moraszk/space-noise-o-meter/README.md

Móra Space module
=================

Students from Ferenc Mora College for Advanced Studies developed a payload for the MRC-100 satellite. These are the sources of it.
