moraszk/space-noise-o-meter/doc/report.tex

\subsection{Mass}
\vspace{15mm}
\begin{tabular}{@{}C{1.5in}@}
	\hrulefill & \hfill \\
	Identifier & \hfill \\
\end{tabular}
\vspace{25mm}

\begin{tabular}{@{}C{1.5in}p{1in}C{1.5in}p{1in}C{1.5in}@{}}
	\hrulefill & \hfill & \hrulefill & \hfill & \hrulefill\\
	Instrument & \hfill & Mass & \hfill & Signature \\
\end{tabular}

\subsection{Current at $V_{in}=3.3V$}
\vspace{25mm}
\begin{tabular}{@{}C{1.5in}p{1in}C{1.5in}p{1in}C{1.5in}@{}}
	\hrulefill & \hfill & \hrulefill & \hfill & \hrulefill\\
	Instrument & \hfill & Current & \hfill & Signature \\
\end{tabular}

\subsection{Thermal-chamber}
\vspace{25mm}
\begin{tabular}{@{}C{1.5in}p{1in}C{1.5in}p{1in}C{1.5in}@{}}
	\hrulefill & \hfill & \hrulefill & \hfill & \hrulefill\\
	Instrument & \hfill & Pass & \hfill & Signature \\
\end{tabular}
