moraszk/space-noise-o-meter/presentation/mrc_napok.tex

\begin{frame}{SZTE Akadémiai modul}
\begin{columns}[c]
\column{.5\textwidth}
\begin{block}{Megvalósulás}
2022Q1-Q2, két kar, kari és intézeti költségvetésekből, a lehetőséget a BME biztosította
\end{block}
\begin{block}{Kísérletek}
	\begin{itemize}
		\item Különböző elvű hőmérséklet mérések
		\item A belső oszcillátor kalibrációs adatainak mérése
	\end{itemize}
\end{block}

\column{.45\textwidth}
	\begin{center}
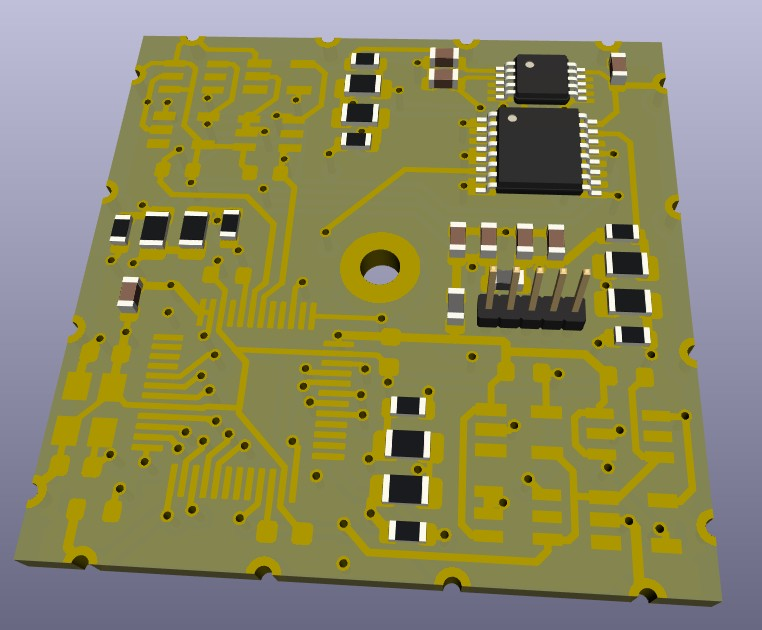
[picture p1: presentation/tanszeki3d.jpg]
		
	\end{center}

\end{columns}
\end{frame}

\begin{frame}{SZTE Diák-modul}
\begin{columns}
\column{.45\textwidth}
	\begin{center}
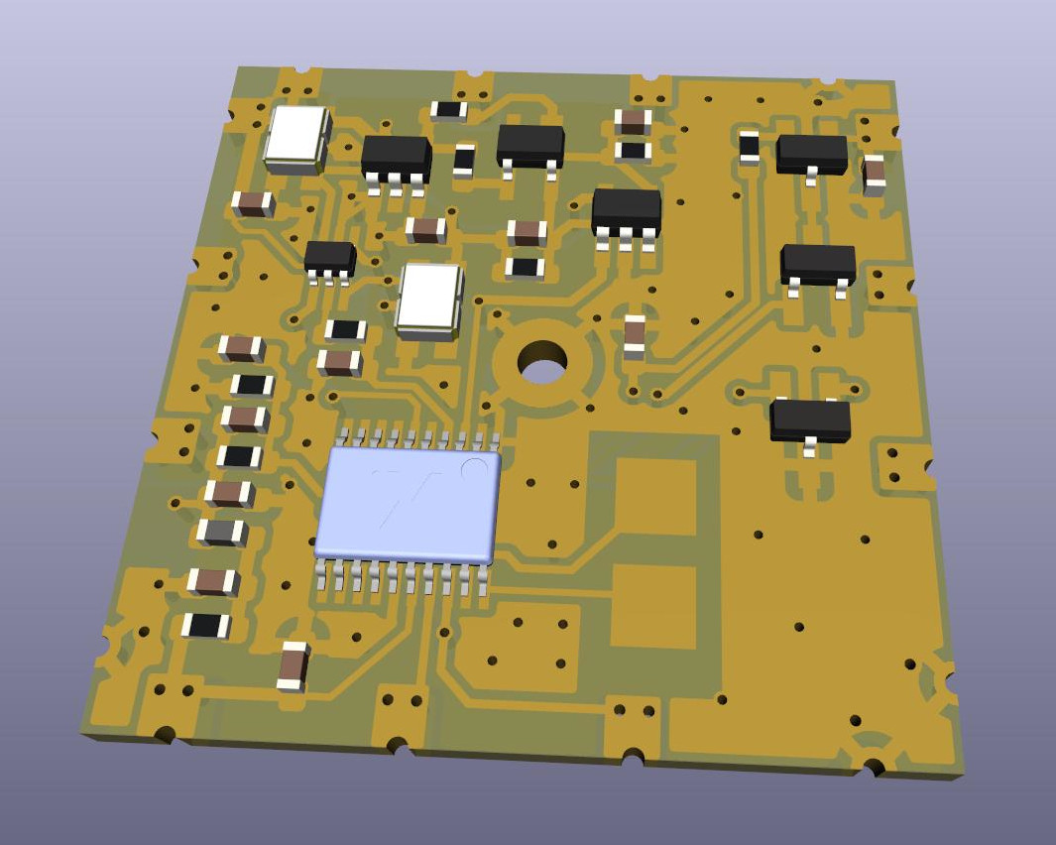
[picture p2: presentation/3d_render.jpg]
		
	\end{center}
	\begin{block}{Szponzoraink}
			
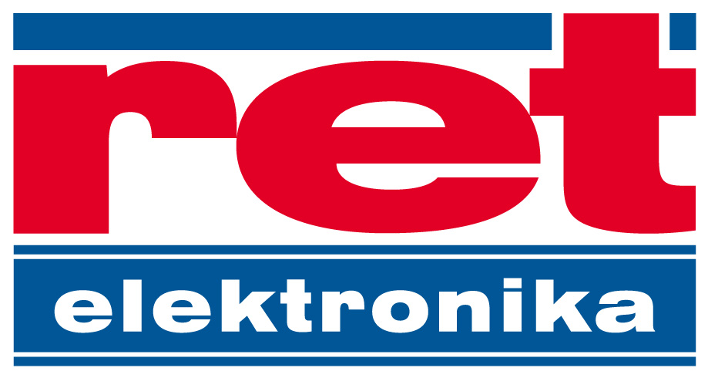
[picture p3: presentation/ret.jpg]
			
			
			
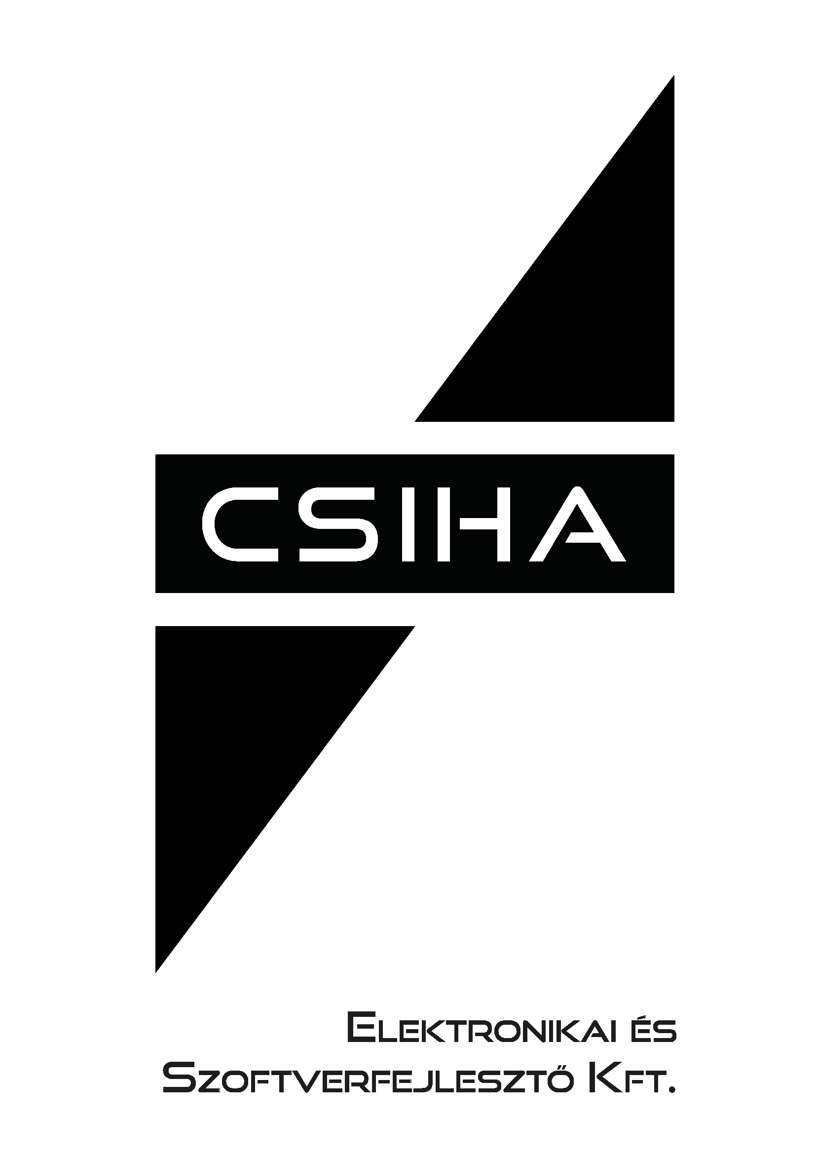
[picture p4: presentation/csiha.png]
			
	\end{block}
\column{.5\textwidth}
	\begin{block}{Megvalósulás}
		\small{2022 szeptember 30--október 24, kizárólag diákok tervezésével és menedzselésével az SZTE Móra Ferenc Szakkollégiumban. A lehetőséget a BME biztosította.}
	\end{block}
	\begin{block}{Kísérletek}
		\begin{itemize}
			\item STM32 beépített ADC viselkedése
			\item A közös busz UART jitterének mérése modulonként
			\item Helyi bölcsész közösség idézetgyűjteménye
			\item Mágneses indukcióerősség mérés
			\item Hőmérséklet mérés
			\item TicTacToe
		\end{itemize}
	\end{block}
\end{columns}
\end{frame}
