moraszk/space-noise-o-meter/presentation/sponsors.tex

\begin{frame}{Szponzoraink}





\end{frame}

\begin{frame}{Felhasznált nyílt kódú szoftverek}
	\LaTeX
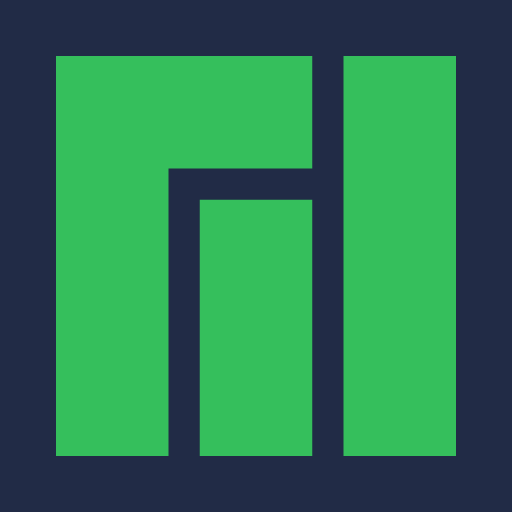
[picture p15: presentation/manjaro.png]
	
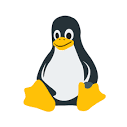
[picture p16: presentation/linux.png]
	
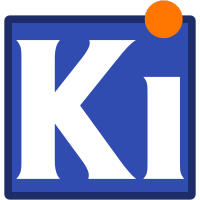
[picture p17: presentation/kicad.png]
	
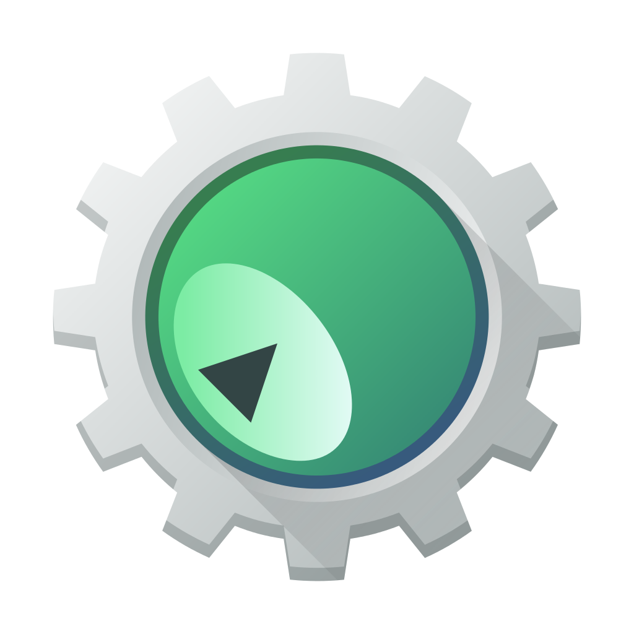
[picture p18: presentation/kdevelop.png]
	
	
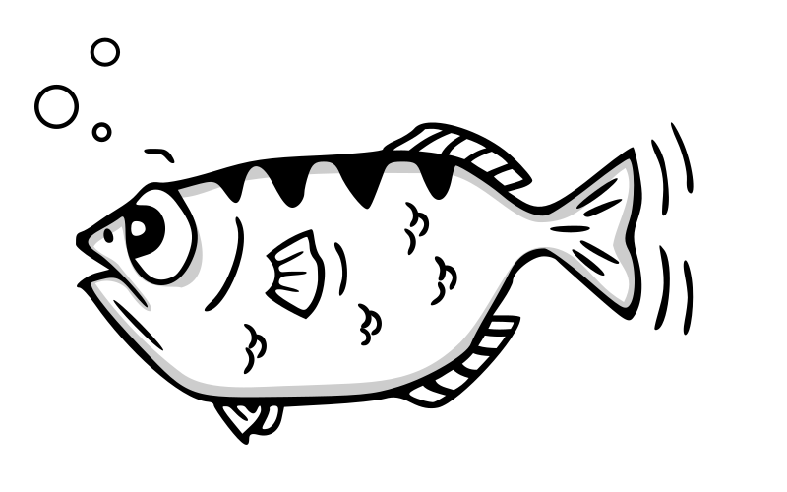
[picture p19: presentation/gdb.png]
	
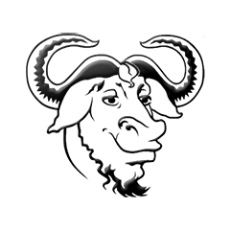
[picture p20: presentation/make.png]
	
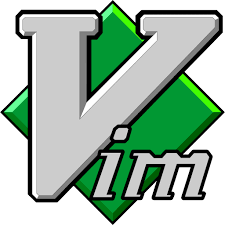
[picture p21: presentation/vim.png]
	
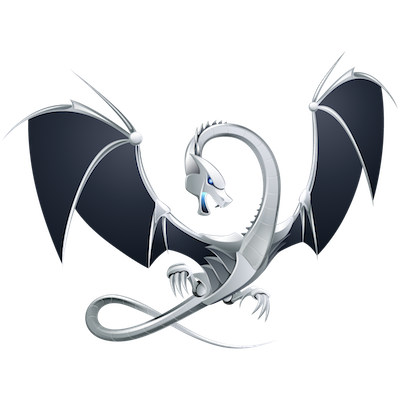
[picture p22: presentation/llvm.png]
	
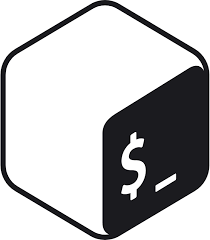
[picture p23: presentation/bash.png]
	
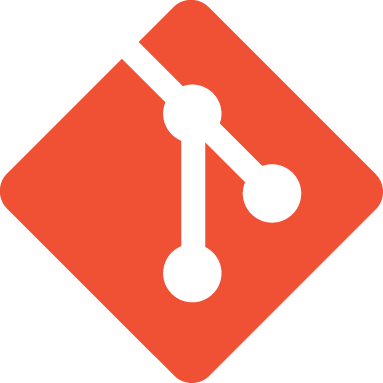
[picture p24: presentation/git.png]
	
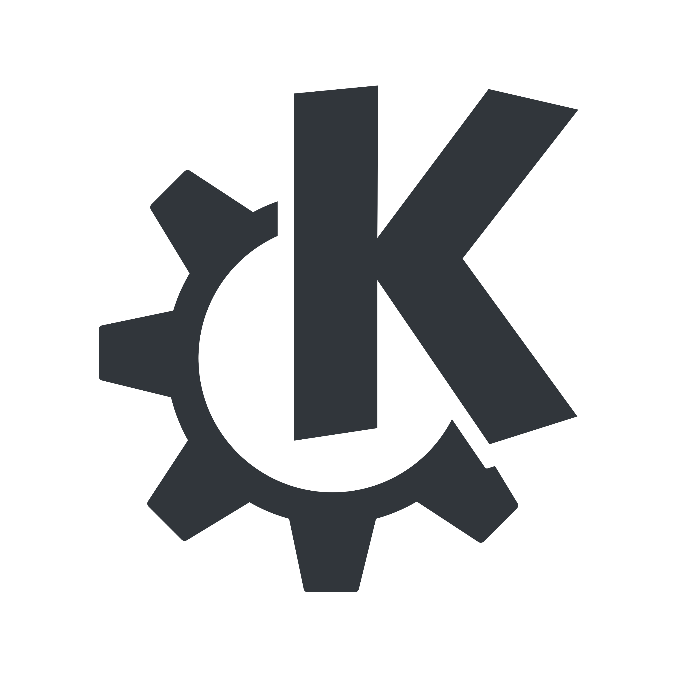
[picture p25: presentation/kde.png]
	
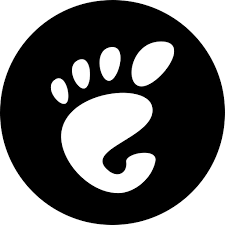
[picture p26: presentation/gnome.png]
	
\end{frame}
