moraszk/space-noise-o-meter/presentation/mfhe.jpeg

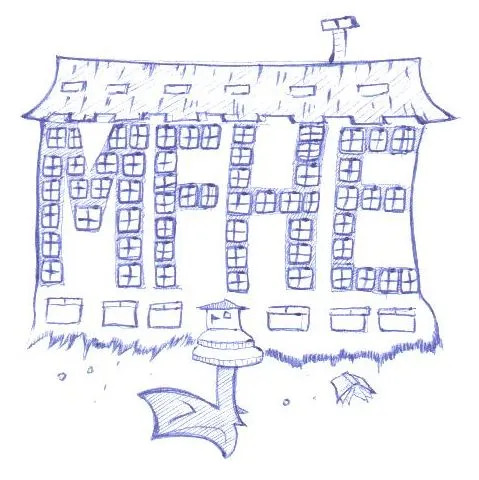
presentation/mfhe.jpeg
