moraszk/space-noise-o-meter/presentation/rocketlab.png

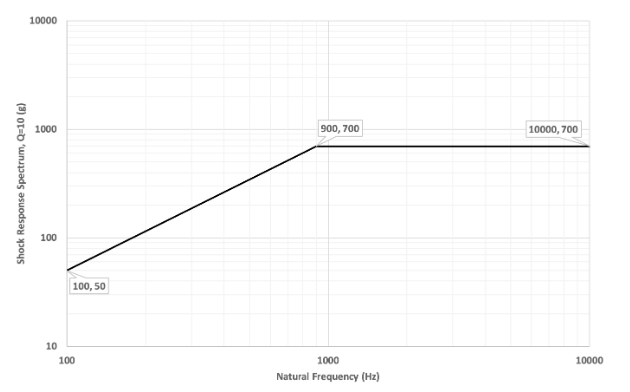
presentation/rocketlab.png
