moraszk/space-noise-o-meter/hw/footprint/farnell/xtal_osc_3.2x2.5.step

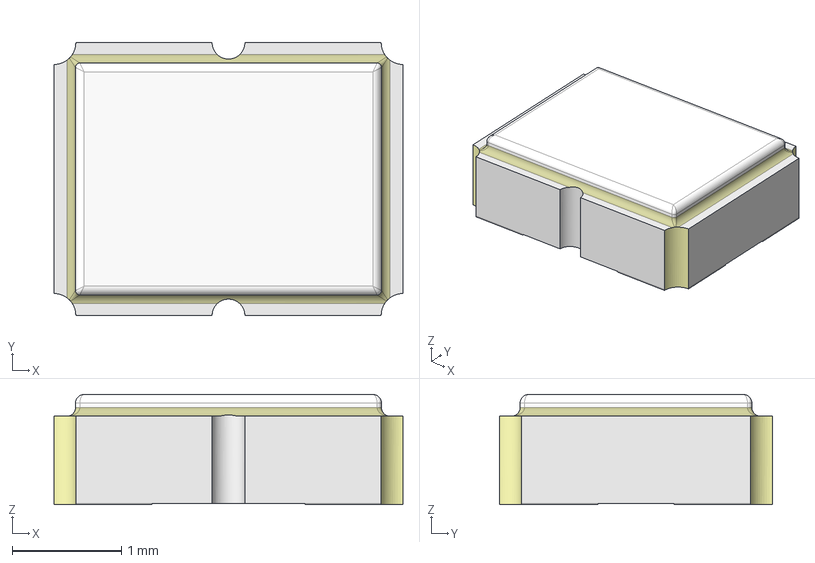
[picture p33: CAD file, 2022-10-05]
hw/footprint/farnell/xtal_osc_3.2x2.5.step
3.20 x 2.50 x 1.01 mm
