moraszk/space-noise-o-meter/hw/module.step

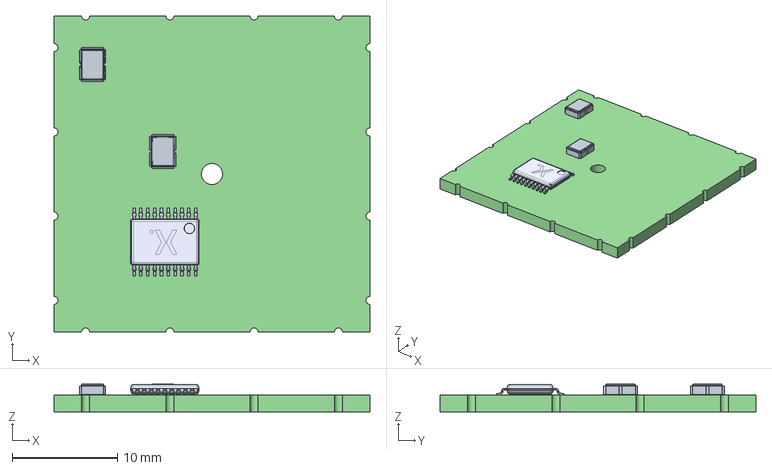
[picture p34: CAD file, 2022-10-10]
hw/module.step
30.0 x 30.0 x 2.65 mm
module PCB
