moraszk/space-noise-o-meter/hw/footprint/farnell/SOT360-1.step

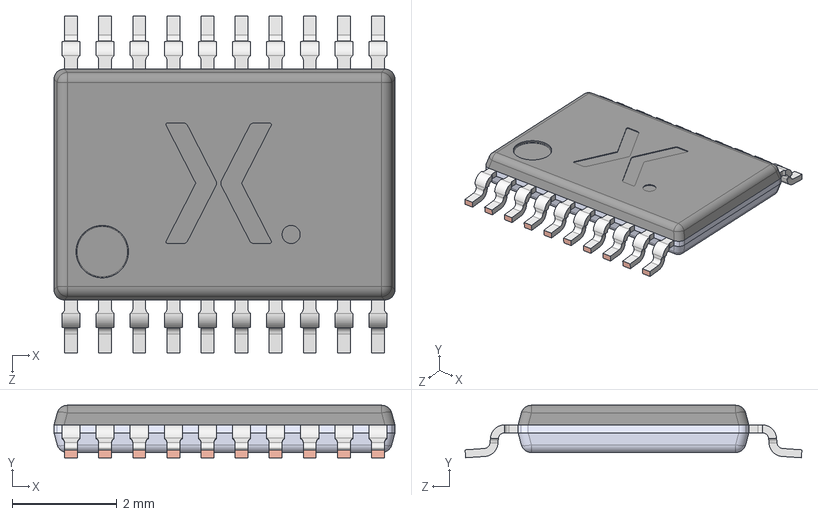
[picture p35: CAD file, 2022-10-04]
hw/footprint/farnell/SOT360-1.step
6.50 x 1.00 x 6.42 mm
SOT360-1 Lower Mold body
SOT360-1 Lead
SOT360-1 Upper Mold body
