moraszk/space-noise-o-meter/doc/sch.pdf

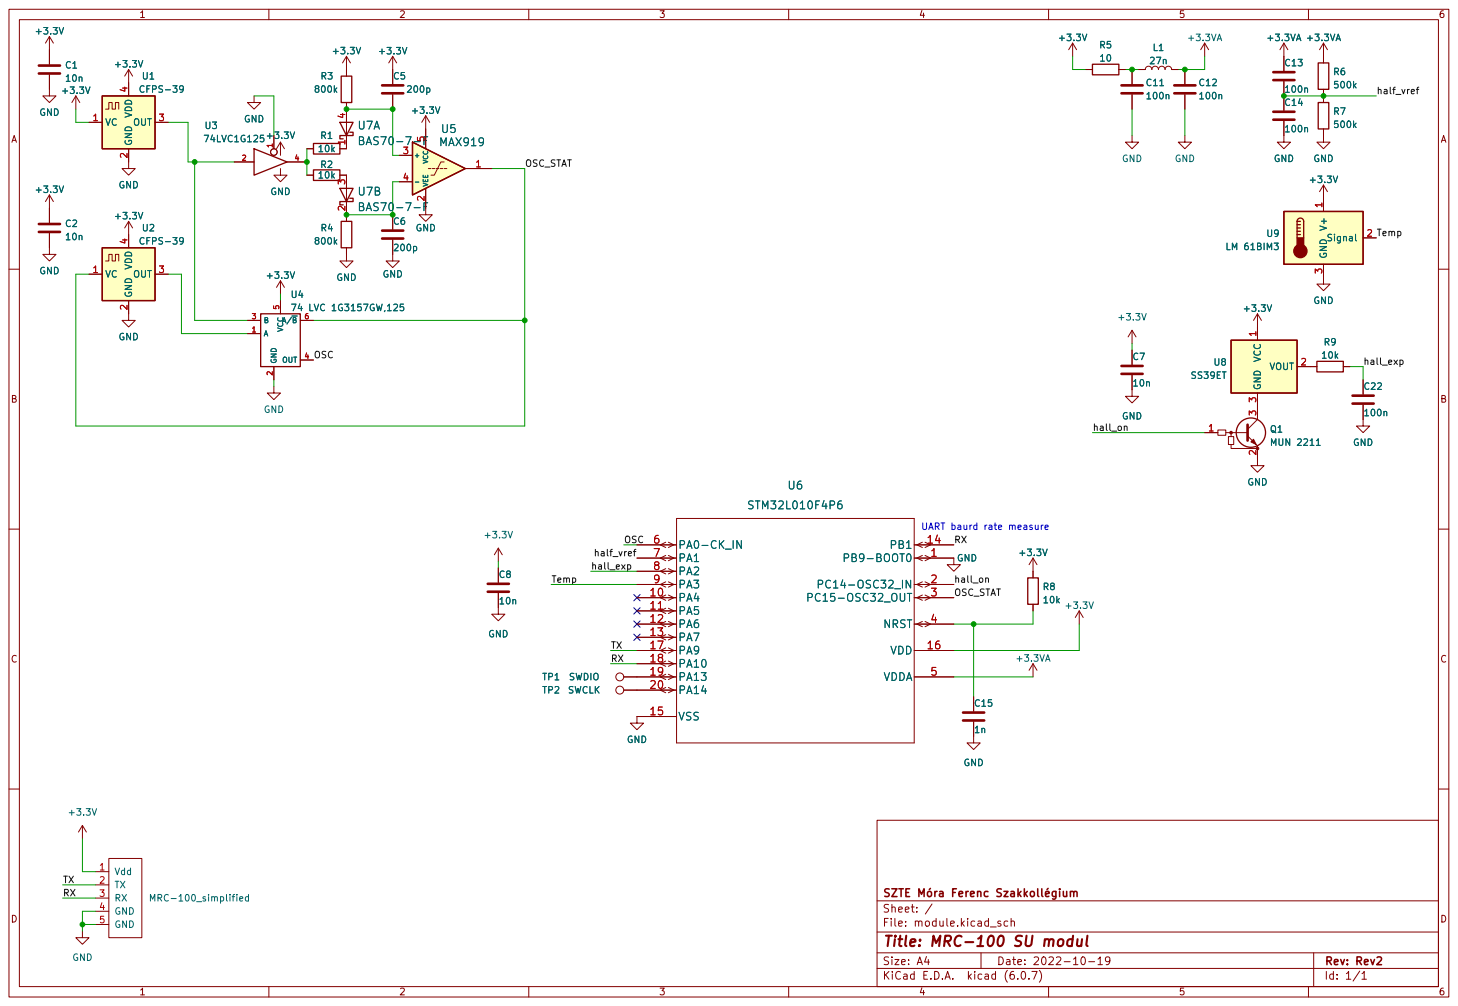
[picture p36: page 1]

File: module.kicad_sch Sheet: / þÿSZTE Móra Ferenc Szakkollégium

Id: 1/1 Title: MRC-100 SU modul
