moraszk/space-noise-o-meter/hw/osc_detect.asc

A1: inv; Vhigh=3.3
C1: cap; 200p
C2: cap; 200p
D1: diode; BAS21HY
D2: diode; BAS21HY
R1: res; 10k
R2: res; 800k
R3: res; 800k
R4: res; 1
R5: res; 100k
R6: res; 10k
V1: voltage; SINE(1.65 1.65 10000000)
V2: voltage; 3.3
Named nets: 0, low, high
.tran 100u uic
