moraszk/space-noise-o-meter/hw/module.kicad_pcb

## KiCad design hw/module.kicad_pcb (2022-10-22)

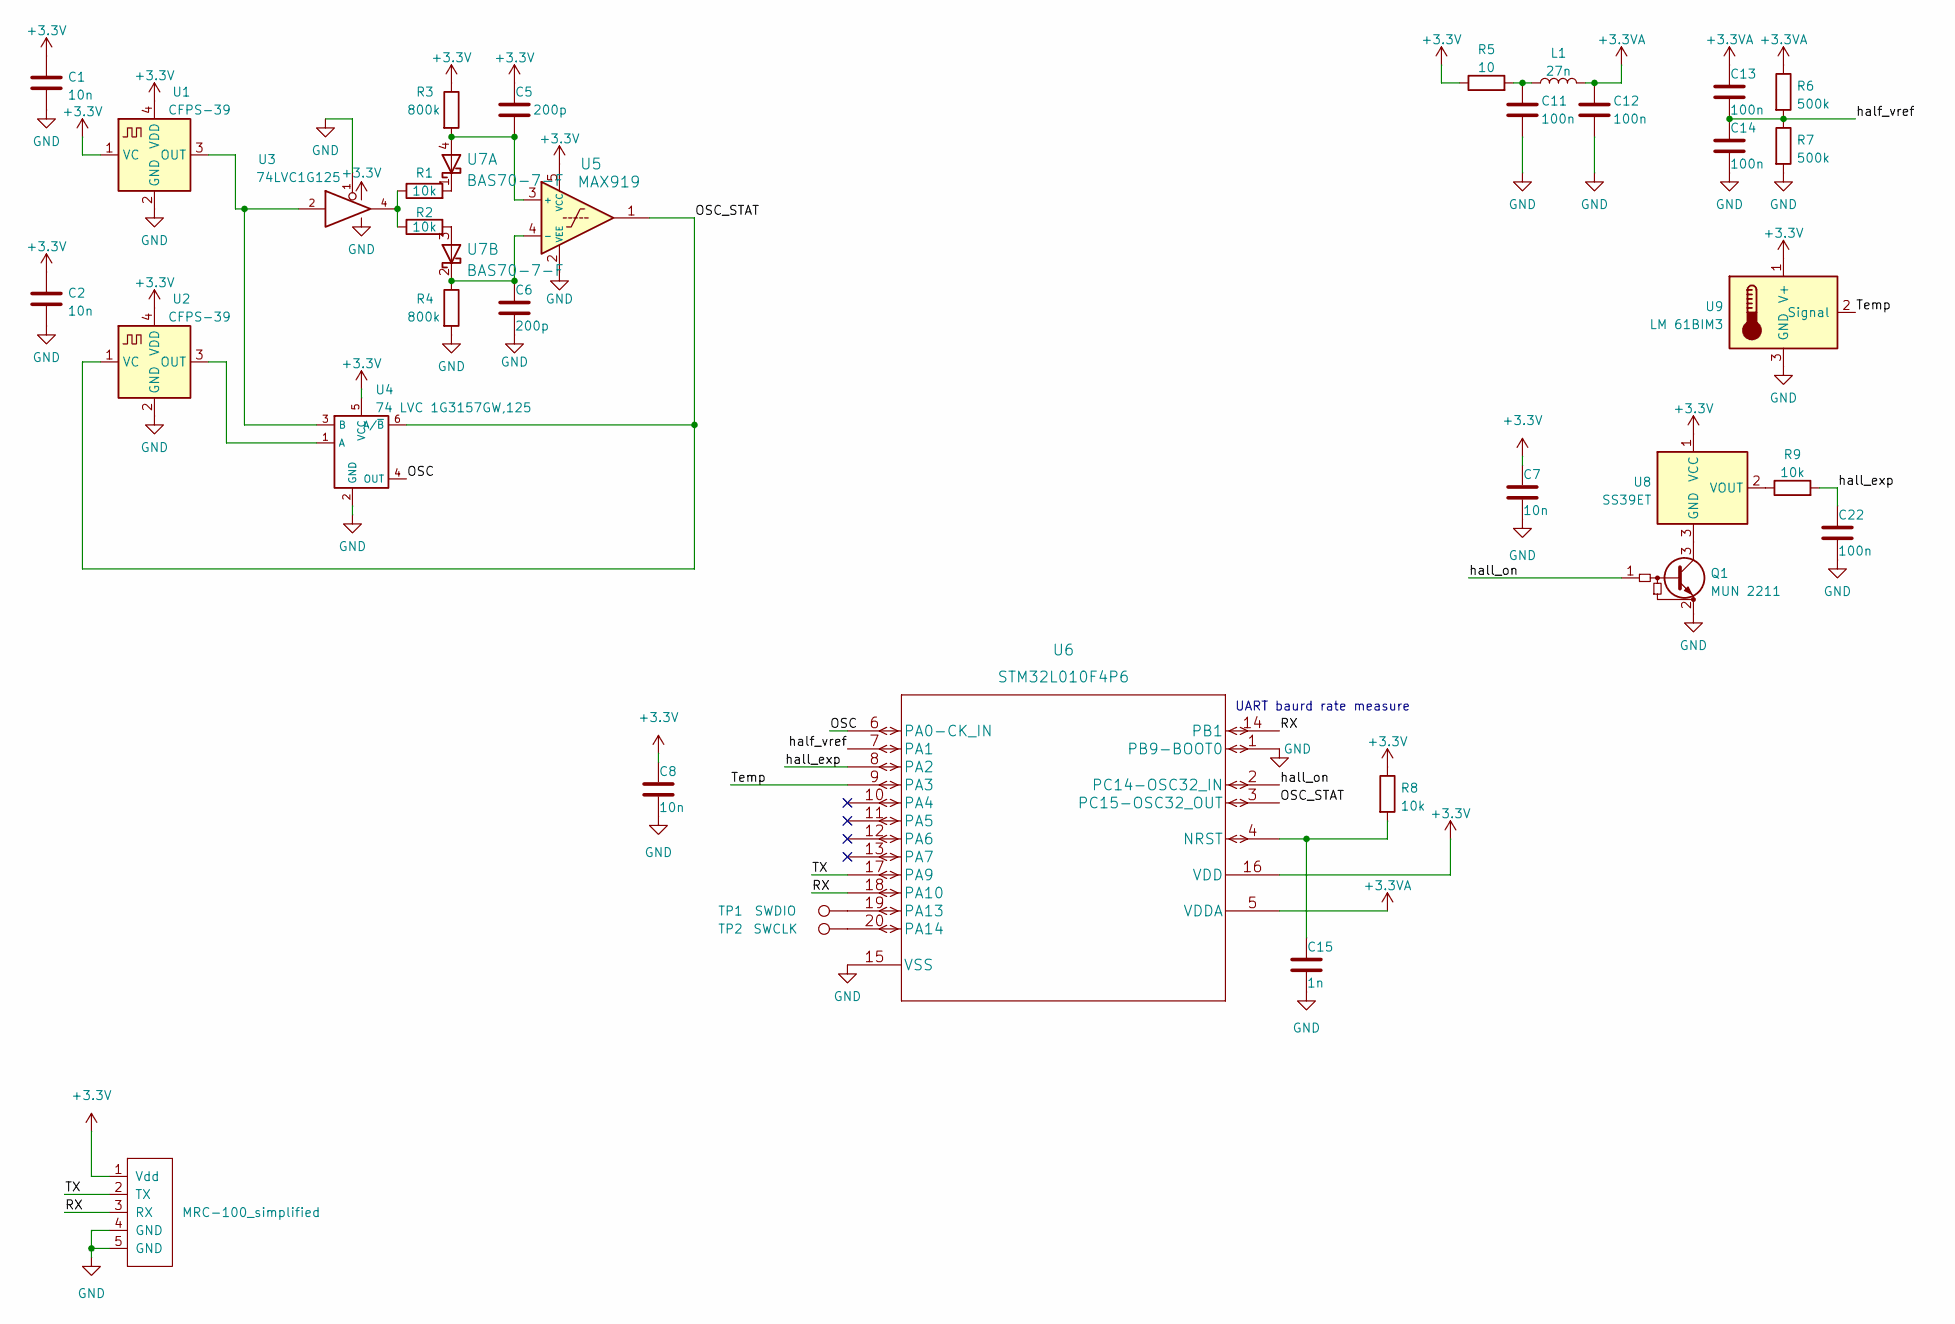
[picture p37: schematic module.kicad_sch, MRC-100 SU modul]

Parts:
C1, C2, C7, C8: 10n; C_0603_1608Metric_Pad1.08x0.95mm_HandSolder
C5, C6: 200p; C_0603_1608Metric_Pad1.08x0.95mm_HandSolder
C11, C12, C13, C14, C22: 100n; C_0603_1608Metric_Pad1.08x0.95mm_HandSolder
C15: 1n; C_0603_1608Metric_Pad1.08x0.95mm_HandSolder
Int1: MRC-100_simplified; mrc-100
L1: 27n; L_0603_1608Metric_Pad1.05x0.95mm_HandSolder
Q1: MUN 2211; SOT-23_Handsoldering
R1, R2, R8, R9: 10k; R_0603_1608Metric_Pad0.98x0.95mm_HandSolder
R3, R4: 800k; R_0603_1608Metric_Pad0.98x0.95mm_HandSolder
R5: 10; R_0603_1608Metric_Pad0.98x0.95mm_HandSolder
R6, R7: 500k; R_0603_1608Metric_Pad0.98x0.95mm_HandSolder
TP1: SWDIO; TestPoint_Pad_3.0x3.0mm
TP2: SWCLK; TestPoint_Pad_3.0x3.0mm
U1, U2: CFPS-39; Oscillator_SMD_EuroQuartz_XO32-4Pin_3.2x2.5mm_HandSoldering
U3: 74LVC1G125; SOT-23-5_HandSoldering
U4: 74 LVC 1G3157GW,125; SOT-363_SC-70-6_Handsoldering
U5: MAX919; SOT-23-5_HandSoldering
U6: STM32L010F4P6
U7: BAS70-7-F; SOT-143_Handsoldering
U8: SS39ET; SOT-23_Handsoldering
U9: LM 61BIM3; SOT-23_Handsoldering

Connections:
+3.3V: C1.1, C2.1, C5.1, C7.1, C8.1, Int1.1 (Vdd), R3.1, R5.1, R8.1, U1.1 (VC), U1.4 (VDD), U2.4 (VDD), U3.5 (VCC), U4.5 (VCC), U5.5 (VCC), U6.16 (VDD), U8.1 (VCC), U9.1 (V+)
+3.3VA: C12.1, C13.1, L1.2, R6.1, U6.5 (VDDA)
/OSC: U4.4 (OUT), U6.6 (PA0-CK_IN)
/OSC_STAT: U2.1 (VC), U4.6 (A/~B), U5.1, U6.3 (PC15-OSC32_OUT)
/RX: Int1.3 (RX), U6.14 (PB1), U6.18 (PA10)
/TX: Int1.2 (TX), U6.17 (PA9)
/Temp: U6.9 (PA3), U9.2 (Signal)
/half_vref: C13.2, C14.1, R6.2, R7.1, U6.7 (PA1)
/hall_exp: C22.1, R9.2, U6.8 (PA2)
/hall_on: Q1.1 (B), U6.2 (PC14-OSC32_IN)
GND: C1.2, C2.2, C6.2, C7.2, C8.2, C11.2, C12.2, C14.2, C15.2, C22.2, Int1.4 (GND), Int1.5 (GND), Q1.2 (E), R4.2, R7.2, U1.2 (GND), U2.2 (GND), U3.1, U3.3 (GND), U4.2 (GND), U5.2 (VEE), U6.1 (PB9-BOOT0), U6.15 (VSS), U9.3 (GND)
unnamed: C5.2, R3.2, U5.3 (+), U7.4
unnamed: C6.1, R4.1, U5.4 (-), U7.2
unnamed: C11.1, L1.1, R5.2
unnamed: C15.1, R8.2, U6.4 (NRST)
unnamed: Q1.3 (C), U8.3 (GND)
unnamed: R1.1, R2.1, U3.4
unnamed: R1.2, U7.1
unnamed: R2.2, U7.3
unnamed: R9.1, U8.2 (VOUT)
unnamed: TP1.1, U6.19 (PA13)
unnamed: TP2.1, U6.20 (PA14)
unnamed: U1.3 (OUT), U3.2, U4.3 (B)
unnamed: U2.3 (OUT), U4.1 (A)

Notes on the sheet:
UART baurd rate measure

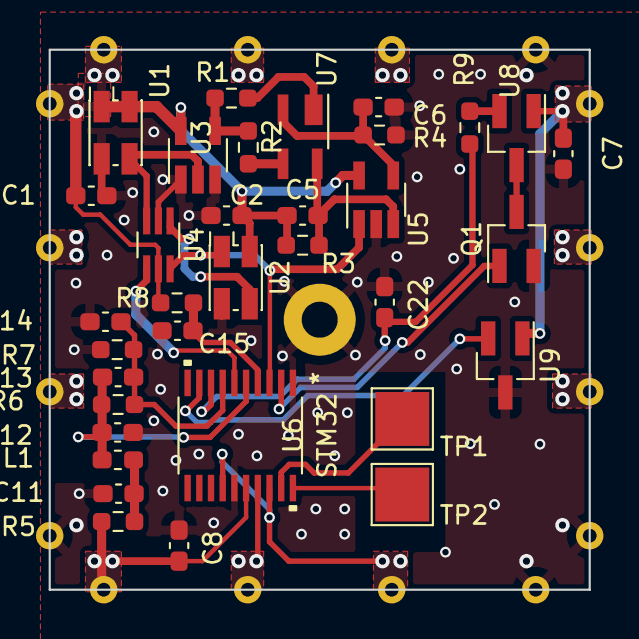
[picture p38: board module.kicad_pcb from above]

Board: 2 copper layers, 30.0 x 30.0 mm, 35 parts (0 on the bottom side), 24 nets.
