moraszk/space-noise-o-meter/(commit log)

2022-10-01 Prepare KiCAD project
    [module.kicad_pcb, module.kicad_sch]
2022-10-01 added stm_footprint
    [module.kicad_sch]
2022-10-02 added Max919_footprint
    [module.kicad_sch]
2022-10-02 Redraw max919 to conventional symbol
    [module.kicad_sch]
2022-10-02 Added redundant oscillator circuit first version
    [module.kicad_sch]
2022-10-02 Placing caps, and stm pinout
    [module.kicad_sch]
2022-10-02 Change oscillator detector resistances
    [module.kicad_sch]
2022-10-02 Border vias added to the PCB
    [module.kicad_pcb]
2022-10-02 added mux
    [module.kicad_sch]
2022-10-02 added bas70 symbol
    [module.kicad_sch]
2022-10-02 Rework bas70
    [module.kicad_sch]
2022-10-02 stm32 wiring
    [module.kicad_sch]
2022-10-03 Footprint assignment
    [module.kicad_pcb, module.kicad_sch]
2022-10-03 PCB arrange
    [module.kicad_pcb, module.kicad_sch]
2022-10-03 PCB wiring
    [module.kicad_pcb]
2022-10-04 Add 3D models
    [SOT360-1.step, module.kicad_pcb, module.kicad_sch]
2022-10-04 Footprint fix, and first PCB release
    [module.kicad_pcb, module.kicad_sch]
2022-10-05 Final 3D models, final capacitor sizes, final capacitor numbers, final capacitor placements
    [module.kicad_pcb, module.kicad_sch, xtal_osc_3.2x2.5.step]
2022-10-06 Add extra resistor for capacitor measure, remove out-the-board wires
    [module.kicad_pcb, module.kicad_sch]
2022-10-09 Status counters at uart
2022-10-09 uart registers and sysclock config
2022-10-10 Add base64 encoder
    [module.step]
2022-10-10 adc init
2022-10-10 edit adc init
2022-10-11 Document and fix mcu startup process
    [main.cpp, sysclock_config.cpp]
2022-10-12 Fix bug in ringbuffer
    [utils.hpp]
2022-10-12 Fix size_t namespace in ringbuffer
    [utils.hpp]
2022-10-13 0603 passives
    [module.kicad_pcb, module.kicad_sch]
2022-10-14 Add the last wire
    [module.kicad_pcb]
2022-10-14 fix assembly extension
2022-10-14 Move via
    [module.kicad_pcb]
2022-10-14 Fix checksum system, and command receiver types, containers
    [CommandReceiver.hpp, checksum.cpp, checksum.hpp, command_receiver.cpp, main.cpp, utils.hpp]
2022-10-14 Extend and fix compiler warnings
    [command_receiver.cpp]
2022-10-16 UART timing experiment implemetnation vol. 1
2022-10-18 Create fuzz test to check for memory safty and valid output of the base64 encoder
2022-10-18 refactor command::destinintion's location, which oscillator in status etc. sw++
    [CommandReceiver.hpp, WDG.cpp, command.hpp, command_sender.hpp, gpio.hpp, main.cpp, measure_memory.hpp, status.hpp]
2022-10-18 hotfix for compile errors
    [TIM.cpp, command_sender.cpp, telecommand.cpp, utils.cpp, utils.hpp]
2022-10-19 Emplace new in receive buffer memory footprint reduced
2022-10-19 reduce main memory footprint
2022-10-19 Fix crash on empty input
    [checksum.cpp]
2022-10-19 Redraw sch for the datasheet
    [module.kicad_sch]
2022-10-19 fix uart init
2022-10-20 ADC with DMA
2022-10-20 Fix local include with angle style
    [measure_memory.hpp]
2022-10-20 Fix UART GPIO settings
    [gpio.cpp, sysclock_config.cpp]
2022-10-20 uart communication worksgit add .!
2022-10-22 uart baud rate experiment fixes
    [main.cpp]
2022-10-22 added bom
    [module.kicad_pcb]
2022-10-23 adc noise measure complete
    [main.cpp, measure_memory.hpp, status.hpp, telecommand.cpp]
2022-10-23 Reset tictactoe board on invalid move
    [tictactoe.cpp]
2022-10-23 fix adc dma offset
    [adc.cpp]
2022-10-23 Fix no ack for commands
    [main.cpp, telecommand.cpp]
2022-10-23 fix uart baud measure
    [measure_memory.hpp]
2022-10-23 add hall commands
2022-10-23 Revert "Fix no ack for commands"
    [main.cpp, telecommand.cpp]
2022-11-26 Ground telemetry parser proof of concept
2022-11-26 Temperature and supply voltage output
